clementzheng/press-kit/img/PCB-preview.png

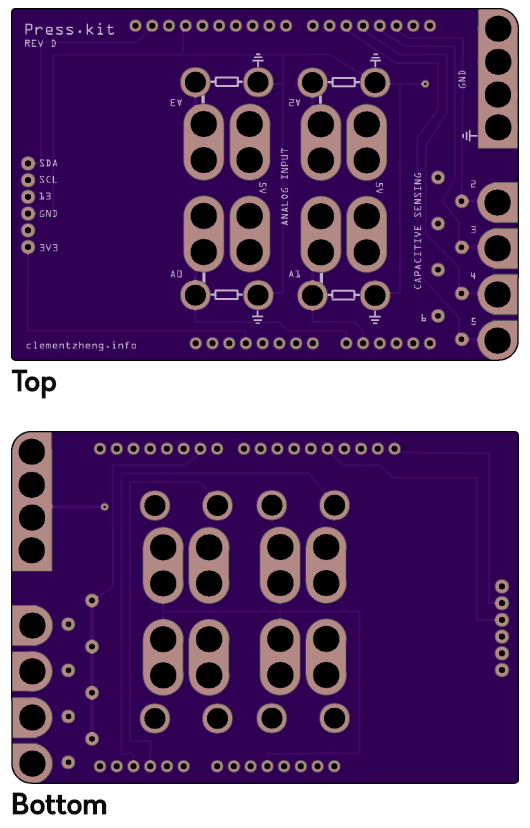
img/PCB-preview.png
